Greg-R/rpikobhat/doc/rpikobhat.pdf

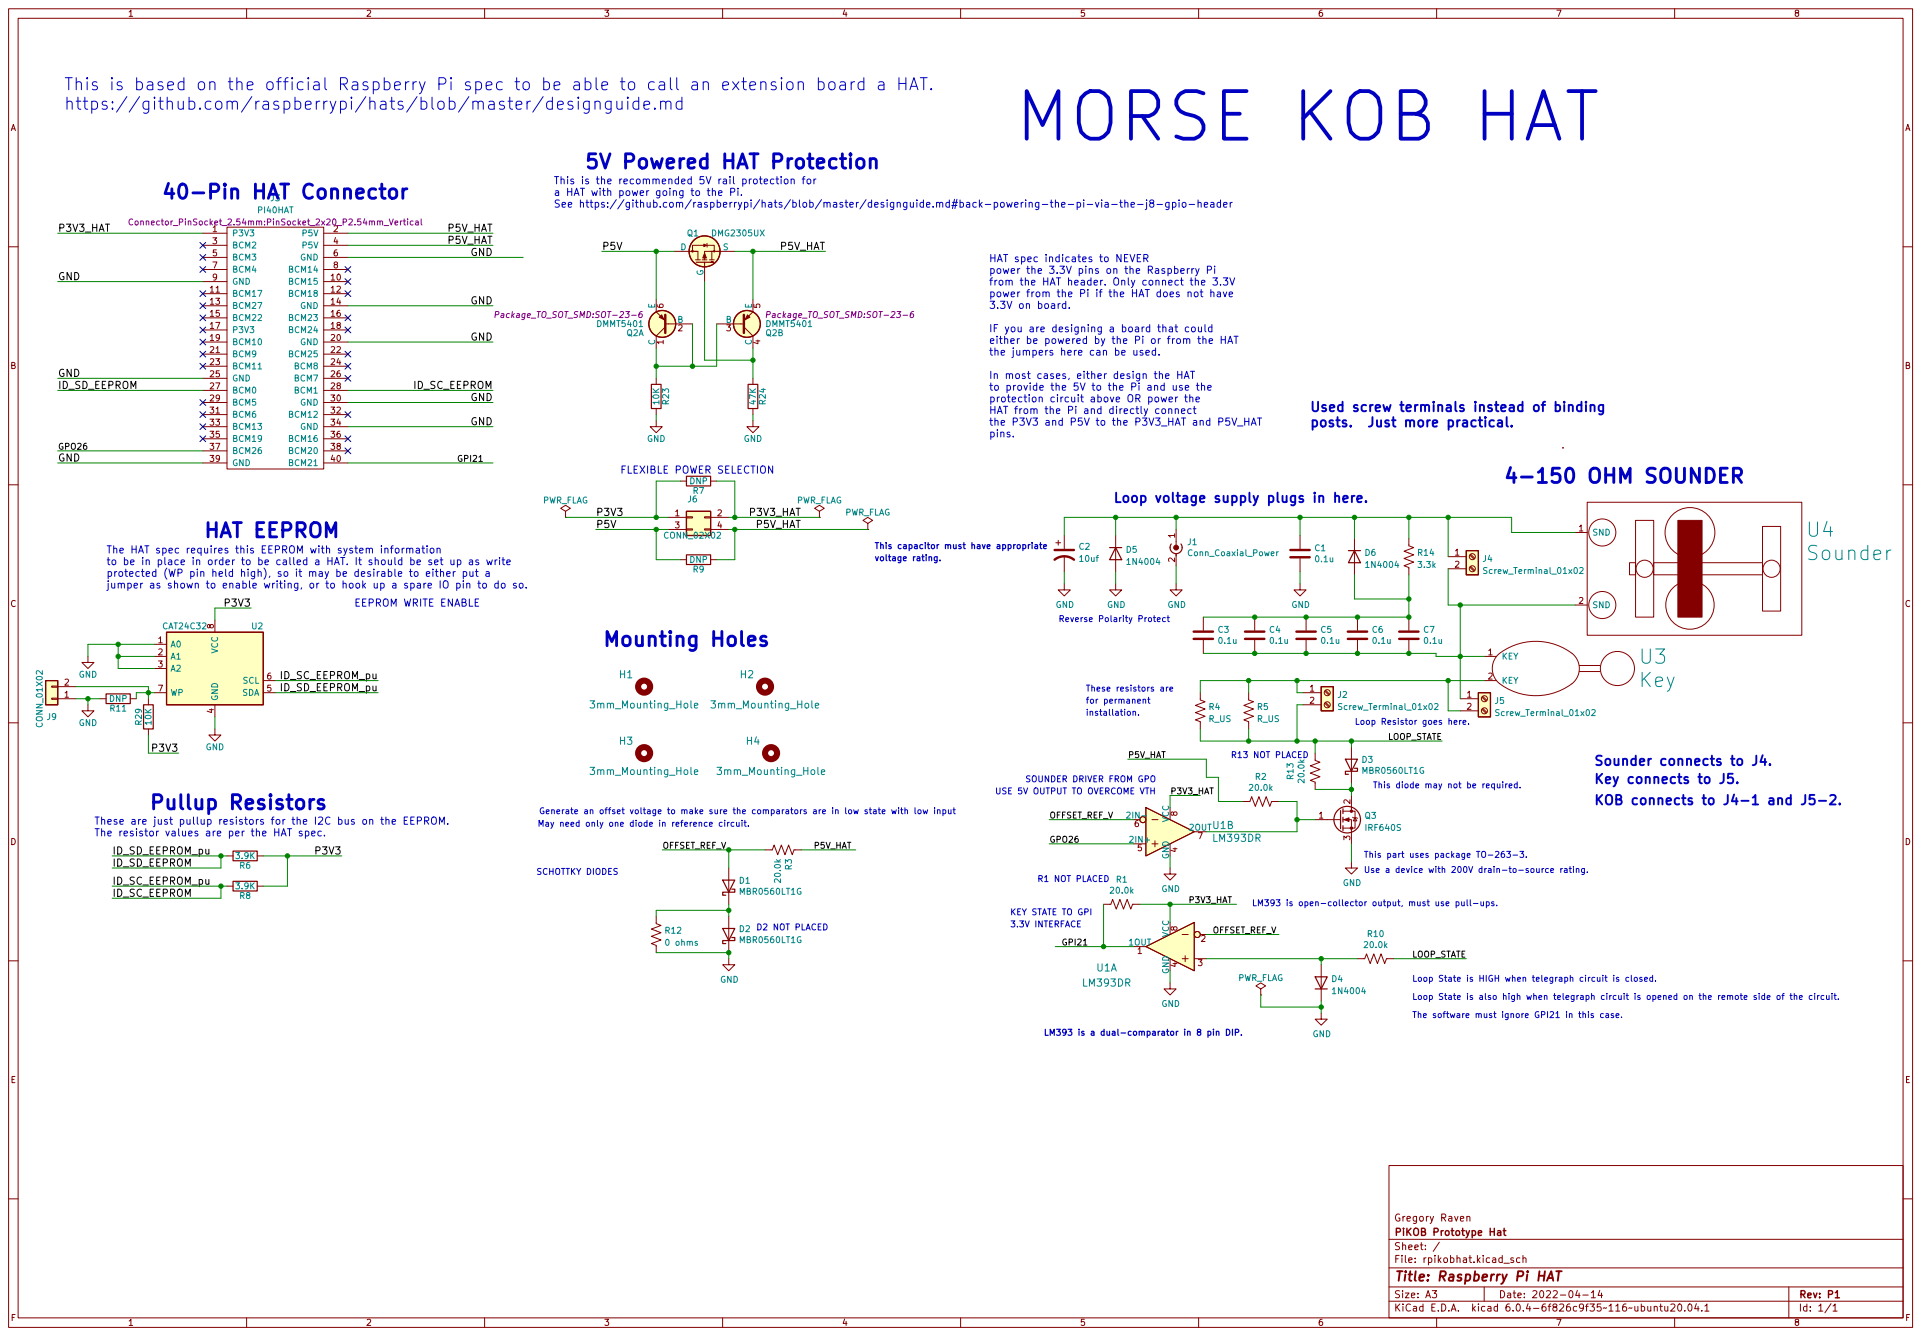
[picture p1: page 1]

This diode may not be required. These resistors are This is based on the official Raspberry Pi spec to be able to call an extension board a HAT.
https://github.com/raspberrypi/hats/blob/master/designguide.md

Loop voltage supply plugs in here. SCHOTTKY DIODES 40-Pin HAT Connector
J3 PI40HAT Connector_PinSocket_2.54mm:PinSocket_2x20_P2.54mm_Vertical

This is the recommended 5V rail protection for
a HAT with power going to the Pi.
See https://github.com/raspberrypi/hats/blob/master/designguide.md#back-powering-the-pi-via-the-j8-gpio-header

HAT spec indicates to NEVER
power the 3.3V pins on the Raspberry Pi
from the HAT header. Only connect the 3.3V
power from the Pi if the HAT does not have
3.3V on board.

IF you are designing a board that could
either be powered by the Pi or from the HAT
the jumpers here can be used.

In most cases, either design the HAT
to provide the 5V to the Pi and use the
protection circuit above OR power the
HAT from the Pi and directly connect
the P3V3 and P5V to the P3V3_HAT and P5V_HAT
pins.

Used screw terminals instead of binding
posts. Just more practical.

The HAT spec requires this EEPROM with system information
to be in place in order to be called a HAT. It should be set up as write
protected (WP pin held high), so it may be desirable to either put a
jumper as shown to enable writing, or to hook up a spare IO pin to do so.

This capacitor must have appropriate
voltage rating.

8 A0 1 A1 2 A2 3 SDA 5 SCL 6 WP 7CAT24C32 U2 GND

Loop Resistor goes here.

USE 5V OUTPUT TO OVERCOME VTH

SOUNDER DRIVER FROM GPO

Generate an offset voltage to make sure the comparators are in low state with low input

These are just pullup resistors for the I2C bus on the EEPROM.

This part uses package TO-263-3.
Use a device with 200V drain-to-source rating.

LM393 is a dual-comparator in 8 pin DIP. R1 NOT PLACED

LM393 is open-collector output, must use pull-ups.

Loop State is HIGH when telegraph circuit is closed.
Loop State is also high when telegraph circuit is opened on the remote side of the circuit.
The software must ignore GPI21 in this case.

File: rpikobhat.kicad_sch Sheet: / PiKOB Prototype Hat

Id: 1/1 Title: Raspberry Pi HAT
