Greg-R/rpikobhat/rpikobhat.kicad_pcb

## KiCad design rpikobhat.kicad_pcb (2022-04-05)

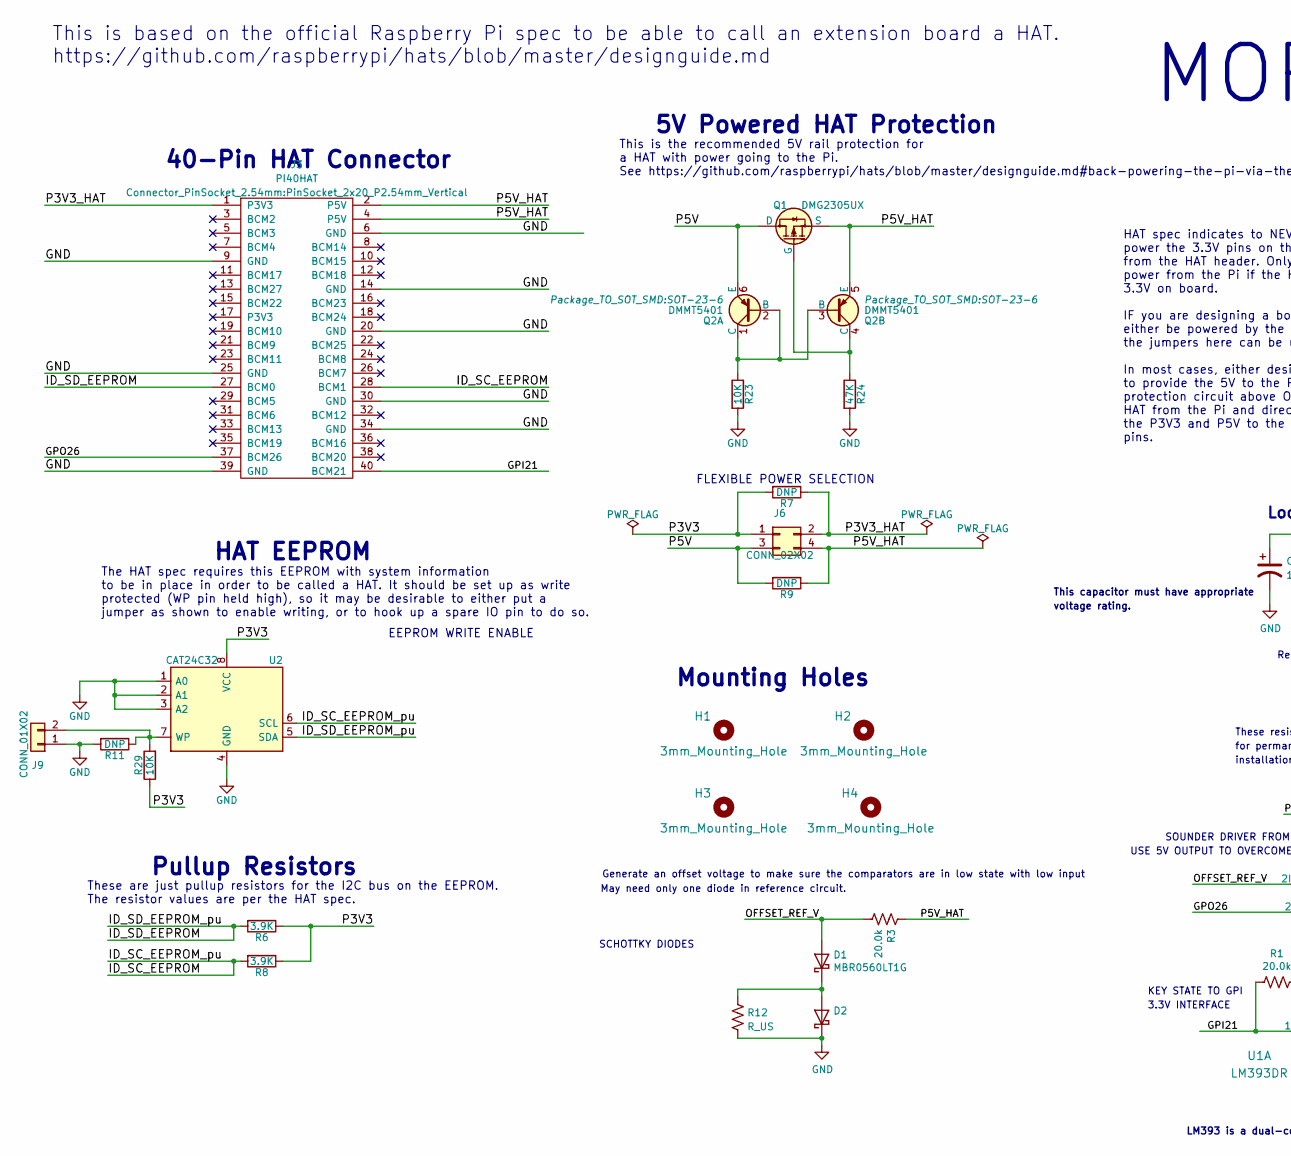
[picture p2: schematic rpikobhat.kicad_sch, Raspberry Pi HAT, part in row 1, column 1]

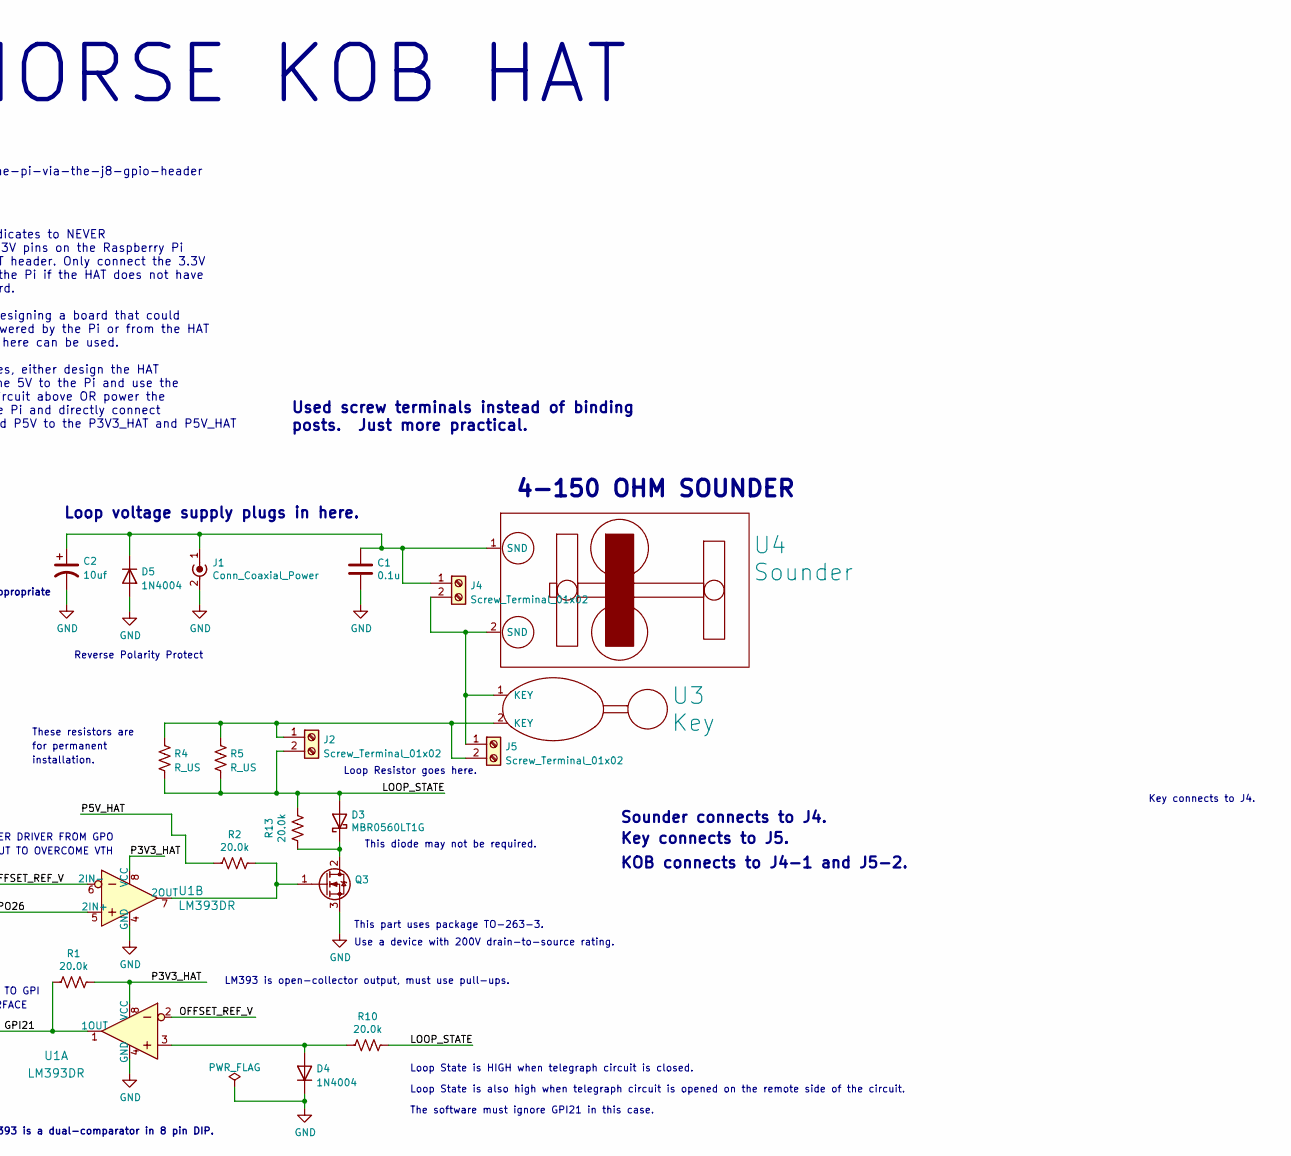
[picture p3: schematic rpikobhat.kicad_sch, Raspberry Pi HAT, part in row 1, column 2]

Parts:
C1: 0.1u
C2: 10uf
D1, D3: MBR0560LT1G; D_SOD-123
D2: (no value)
D4, D5: 1N4004; D_SMB_Handsoldering
H1, H2, H3, H4: 3mm_Mounting_Hole; NPTH_3mm_ID
J1: Conn_Coaxial_Power; BarrelJack_CUI_PJ-036AH-SMT_Horizontal
J2, J4, J5: Screw_Terminal_01x02; TerminalBlock_Philmore_TB132_1x02_P5.00mm_Horizontal
J3: PI40HAT; PinSocket_2x20_P2.54mm_Vertical
J6: CONN_02X02; PinHeader_2x02_P2.54mm_Vertical
J9: CONN_01X02; PinHeader_1x02_P2.54mm_Vertical
Q1: DMG2305UX; SOT-23
Q2: DMMT5401; SOT-23-6
Q3: (no value)
R1, R2, R3, R10, R13: 20.0k; R_1206_3216Metric_Pad1.30x1.75mm_HandSolder
R4, R5: R_US; R_Axial_DIN0414_L11.9mm_D4.5mm_P25.40mm_Horizontal
R6, R8: 3.9K; R_0603_1608Metric_Pad0.84x1.00mm_HandSolder
R7, R9, R11: DNP; R_0603_1608Metric_Pad0.84x1.00mm_HandSolder
R12: R_US; R_1206_3216Metric_Pad1.30x1.75mm_HandSolder
R23, R29: 10K; R_0603_1608Metric_Pad0.84x1.00mm_HandSolder
R24: 47K; R_0603_1608Metric_Pad0.84x1.00mm_HandSolder
U1: LM393DR; DIP-8_W7.62mm; MPN LM393DR; Digi-Key_PN 296-1015-1-ND
U2: CAT24C32; SOIC-8_3.9x4.9mm_P1.27mm
U3: Key
U4: Sounder

Connections:
/GPI21: J3.40 (BCM21), R1.2, U1.1 (1OUT)
/GPO26: J3.37 (BCM26), U1.5 (2IN+)
/ID_SC_EEPROM: J3.28 (BCM1), R8.2, U2.6 (SCL)
/ID_SD_EEPROM: J3.27 (BCM0), R6.2, U2.5 (SDA)
/LOOP_STATE: D3.2 (A), J2.2, R4.2, R5.2, R10.1, R13.1
/OFFSET_REF_V: D1.2 (A), R3.2, U1.2, U1.6 (2IN-)
/P3V3: J6.1, R6.1, R7.2, R8.1, R29.1, U2.8 (VCC)
/P3V3_HAT: J3.1 (P3V3), J6.2, R1.1, R7.1, U1.8 (VCC)
/P5V: J6.3, Q1.3 (D), Q2.6 (E), R9.2
/P5V_HAT: J3.2 (P5V), J3.4 (P5V), J6.4, Q1.2 (S), Q2.5 (E), R2.2, R3.1, R9.1
GND: C1.2, C2.2, D2.1 (K), D4.1 (K), D5.2 (A), J1.2 (Ext), J3.6 (GND), J3.9 (GND), J3.14 (GND), J3.20 (GND), J3.25 (GND), J3.30 (GND), J3.34 (GND), J3.39 (GND), J9.1, Q3.3 (S), R11.2, R12.2, R23.2, R24.2, U1.4 (GND), U2.1 (A0), U2.2 (A1), U2.3 (A2), U2.4 (GND)
unnamed: C1.1, C2.1, D5.1 (K), J1.1 (In), J4.1, U4.1
unnamed: D3.1 (K), Q3.2 (D), R13.2
unnamed: D4.2 (A), R10.2, U1.3
unnamed: J2.1, J5.2, R4.1, R5.1, U3.2
unnamed: J4.2, J5.1, U3.1, U4.2
unnamed: J9.2, R11.1, R29.2, U2.7 (WP)
unnamed: Q1.1 (G), Q2.4 (C), R24.1
unnamed: Q2.1 (C), Q2.2 (B), Q2.3 (B), R23.1
unnamed: Q3.1 (G), R2.1, U1.7 (2OUT)
unnamed: D1.1 (K), D2.2 (A), R12.1

Notes on the sheet:
The HAT spec requires this EEPROM with system information to be in place in order to be called a HAT. It should be set up as write protected (WP pin held high), so it may be desirable to either put a jumper as shown to enable writing, or to hook up a spare IO pin to do so.
HAT EEPROM
This diode may not be required.
Used screw terminals instead of binding posts. Just more practical.
Mounting Holes
Reverse Polarity Protect
Generate an offset voltage to make sure the comparators are in low state with low input
Loop voltage supply plugs in here.
Use a device with 200V drain-to-source rating.
KEY STATE TO GPI
This capacitor must have appropriate
The software must ignore GPI21 in this case.
40-Pin HAT Connector
4-150 OHM SOUNDER
Loop State is HIGH when telegraph circuit is closed.
3.3V INTERFACE
Sounder connects to J4.
These are just pullup resistors for the I2C bus on the EEPROM. The resistor values are per the HAT spec.
voltage rating.
for permanent
EEPROM WRITE ENABLE
installation.
USE 5V OUTPUT TO OVERCOME VTH
This is based on the official Raspberry Pi spec to be able to call an extension board a HAT. https://github.com/raspberrypi/hats/blob/master/designguide.md
This is the recommended 5V rail protection for a HAT with power going to the Pi. See https://github.com/raspberrypi/hats/blob/master/designguide.md#back-powering-the-pi-via-the-j8-gpio-header
MORSE KOB HAT
LM393 is open-collector output, must use pull-ups.
Loop Resistor goes here.
Key connects to J4.
Loop State is also high when telegraph circuit is opened on the remote side of the circuit.
Key connects to J5.
5V Powered HAT Protection
FLEXIBLE POWER SELECTION
These resistors are
Pullup Resistors
SCHOTTKY DIODES
SOUNDER DRIVER FROM GPO
KOB connects to J4-1 and J5-2.
This part uses package TO-263-3.
May need only one diode in reference circuit.
LM393 is a dual-comparator in 8 pin DIP.
HAT spec indicates to NEVER power the 3.3V pins on the Raspberry Pi from the HAT header. Only connect the 3.3V power from the Pi if the HAT does not have 3.3V on board. IF you are designing a board that could either be powered by the Pi or from the HAT the jumpers here can be used. In most cases, e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

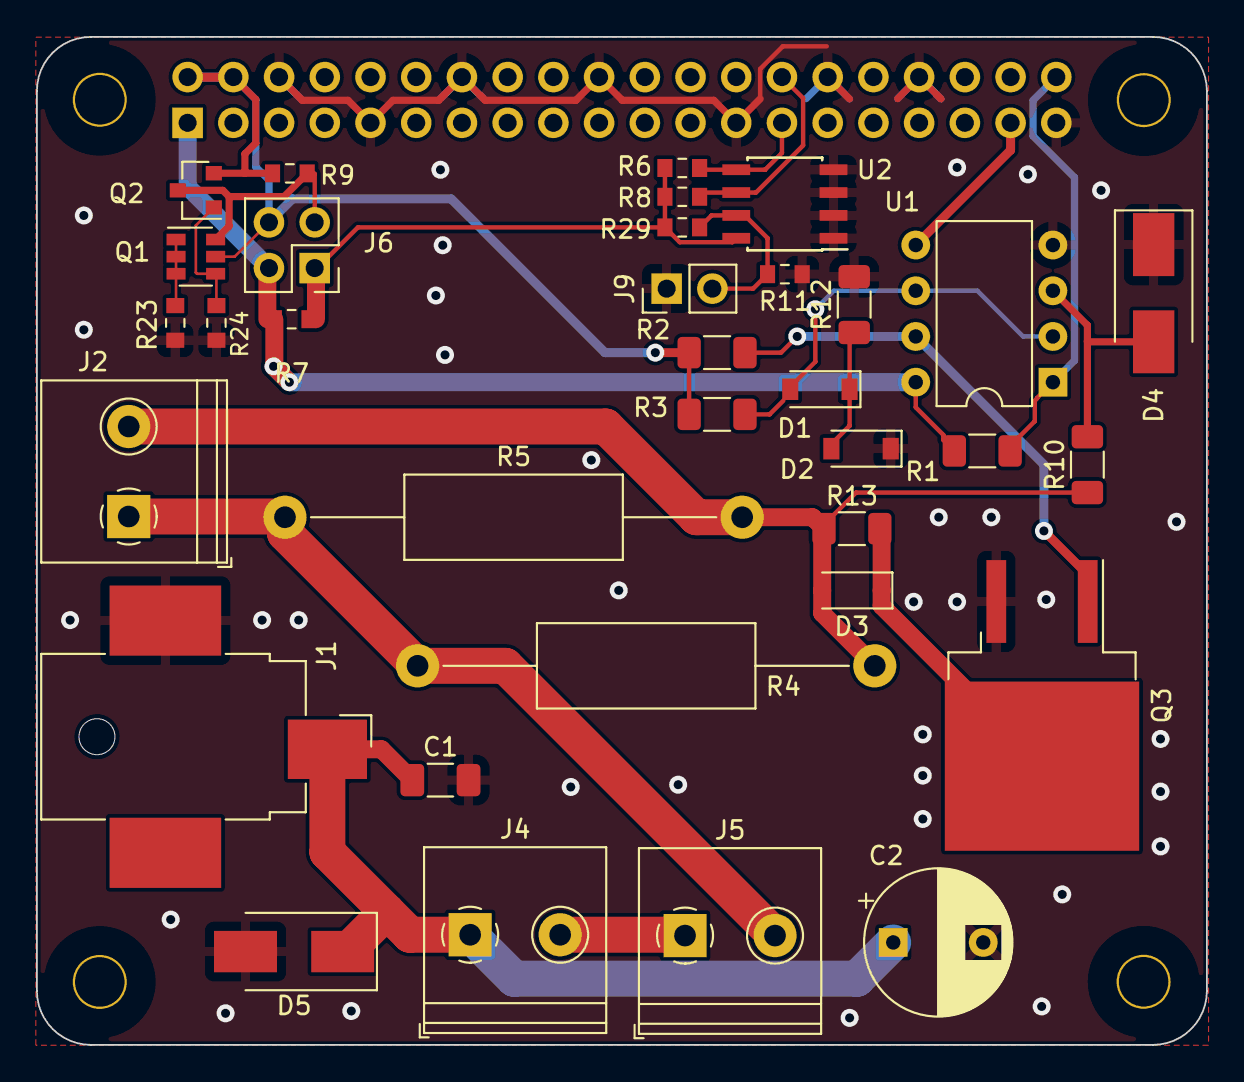
[picture p4: board rpikobhat.kicad_pcb from above]

Board: 2 copper layers, 65.0 x 56.0 mm, 39 parts (1 on the bottom side), 21 nets.
