Greg-R/rpikobhat/(commit log)

2022-03-21 Initial commit.
    [rpikobhat.kicad_pcb, rpikobhat.sch]
2022-03-21 First commit after making pchannel branch
    [rpikobhat.kicad_sch]
2022-03-24 Mostly done. Need to check gerbers.
    [rpikobhat.kicad_pcb, rpikobhat.kicad_sch]
2022-04-05 PCB version 1.0 complete.
    [rpikobhat-B_Cu.gbl, rpikobhat-B_Mask.gbs, rpikobhat-B_Silkscreen.gbo, rpikobhat-Edge_Cuts.gm1, rpikobhat-F_Cu.gtl, rpikobhat-F_Mask.gts, rpikobhat-F_Silkscreen.gto, rpikobhat-NPTH.drl]
2022-04-14 Added a few notes to schematic.
    [rpikobhat.kicad_sch]
2022-04-27 Added snubber to sounder.
    [rpikobhat.kicad_sch]
2022-05-19 Minor changes to notes on schematic.
    [rpikobhat.kicad_sch]
